LorenzoBalducci96/custom-cdj/README.md

# custom-cdj
A raspberry-pi Cdj project realized with the usage of mixxx for the audio software and Arduino Leonardo for input reading. The MIDI protocol is used for the communication between Arduino and the Raspberry.
