LorenzoBalducci96/custom-cdj/documentation.pdf

# Mixxx-based cdj

## A raspberry-pi Cdj project realized with the

## usage of mixxx for the audio software and

Arduino Leonardo for input reading.

## The MIDI protocol is used for the communication

between Arduino and the Raspberry.

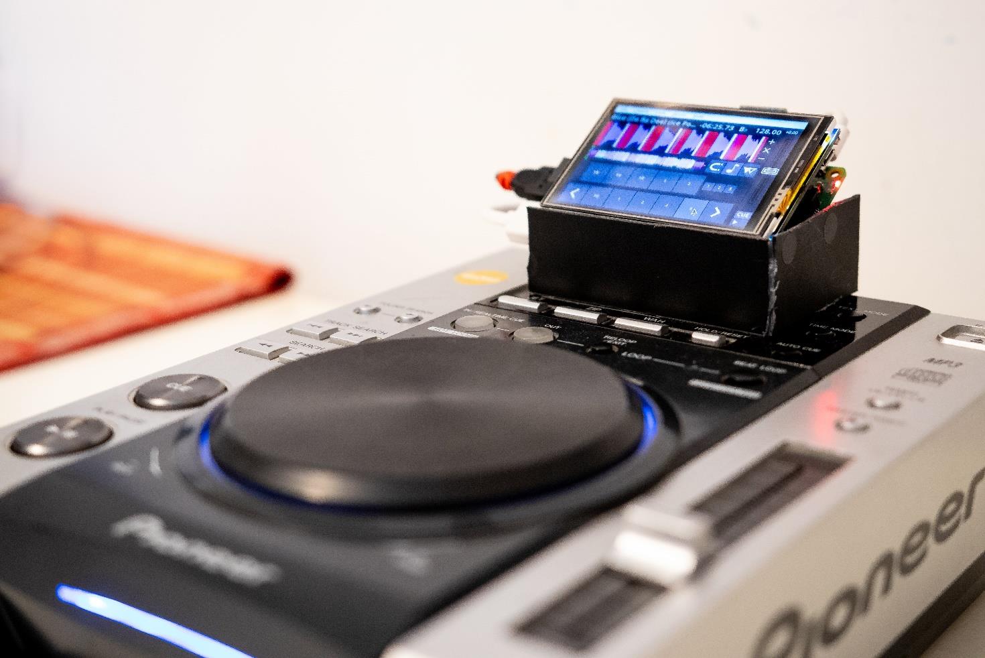
[picture p3: figure]

## Lorenzo Balducci

github: https://github.com/LorenzoBalducci96/

## Used material (for 1 cdj):

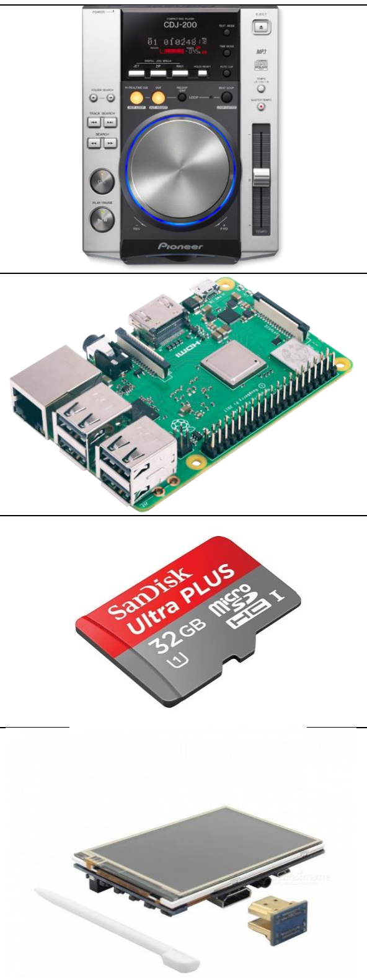
[picture p4: figure]

cdj | In this project we will refer to the pioneer cdj 200. You can use a broken one (all the buttons you want to use, the pitch and the jog must be in working conditions). You can even build your own using buttons, switch, rotary encoders…
raspberry pi 3 b+ | Not tested on other raspberry pi. We will use for running mixxx with our personalized skin.
Micro Sd card | You need a micro sd card because the raspberry pi doesn’t have an internal memory and uses an external sd card for the mass storage.
Raspberry pi screen | I used a 3.5” screen with a 480x320 resolution with touch screen support. You can use a different one but consider that the mixxx skin is all pixel-binded, so if you choose a screen with a different resolution, you will have to scale or adapt my skin. Moreover the waveform will be very fluid with a solid 60fps in a 320p resolution, but will be laggy on higher res.

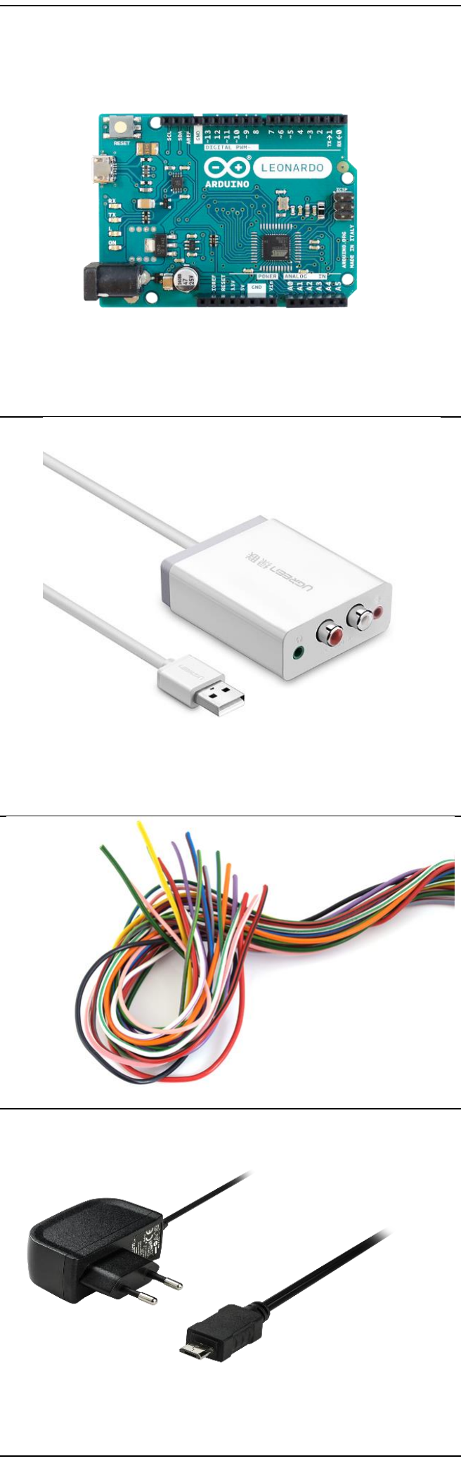
[picture p5: figure]

Arduino leonardo | You have to use the Leonardo version of Arduino because we will use the serial communication over usb. We will use Arduino for continuously reading input data from the cdj and sending over MIDI protocol to the raspberry pi.
Usb sound card | We will use an external sound card for a better sound quality and for reduce latency on mixxx. (You can find very good and cheap usb sound cards but also the 3.5mm jack audio on the raspberry isn’t all that shame).
Electric wires | Used for Making connections between cdj and Arduino.
Raspberry power supply | Classic 5v usb plug (Raccomanded minimum output of 2.5A).

Arduino power supply | You should provide an external power source for Arduino unless you will have a lot of noise on analog reading. Raccomended a 9v.
4.7K Resistors | Used for driving leds. If you don’t want a “bright” cdj you don’t need resistors.

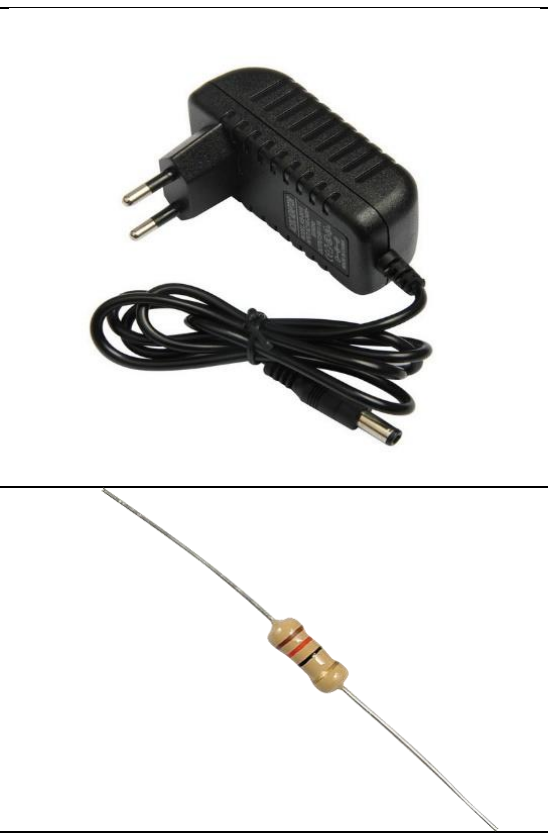
[picture p6: figure]

Of course screwdrivers, welder, and heat-resistant tape.

Fase 1: preparing the cdj

The first step is to prepare the cdj for the connection to the Arduino board.
If you decided to build your own cdj feel free to jump to the next step because here, we are going to analize the disassembly process of pioneer cdj 200.

As stated before, we want to throw away the cdj player and the logical unit from the cdj because we will use just the “buttons”, and we will inject another control unit.

A good video guide that you can follow is this https://www.youtube.com/watch?v=enjz8VNCzuE but please note that you don’t have to disassembly the boards on the upper side of the cdj (the silver one) but you just have to “clean” the bottom side (the black one).

In the end you should have this:

The silver upper part of the cdj:

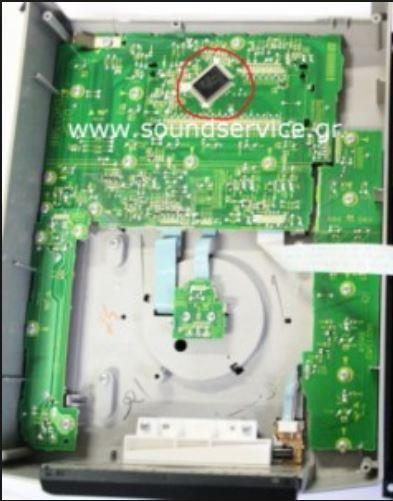
[picture p7: figure]

Disconnected from the bottom black part (leave alone the little flat on the upper part)

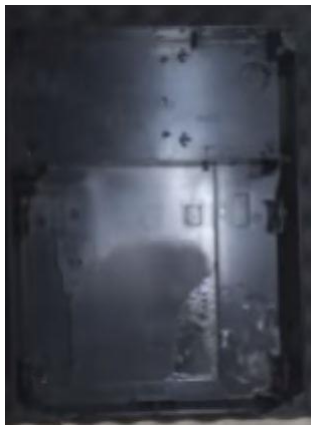
[picture p8: figure]

Fase 2: connecting all the buttons, the jog and the pitch to

Arduino.

Notice: all the buttons on the cdj board shares the same ground, so you have to connect to the Arduino gnp pin just one ground. You can check with a multimeter that all the ground are nearly short-circuited.

Notice2: each end of the wire that will go to the cdj board must be welded.
Each end of the cable going to Arduino can just be plugged in.

In the Arduino code we will read all the buttons with the pull_up method (there are some exception that will be explained).

The decided standard for connections is this:

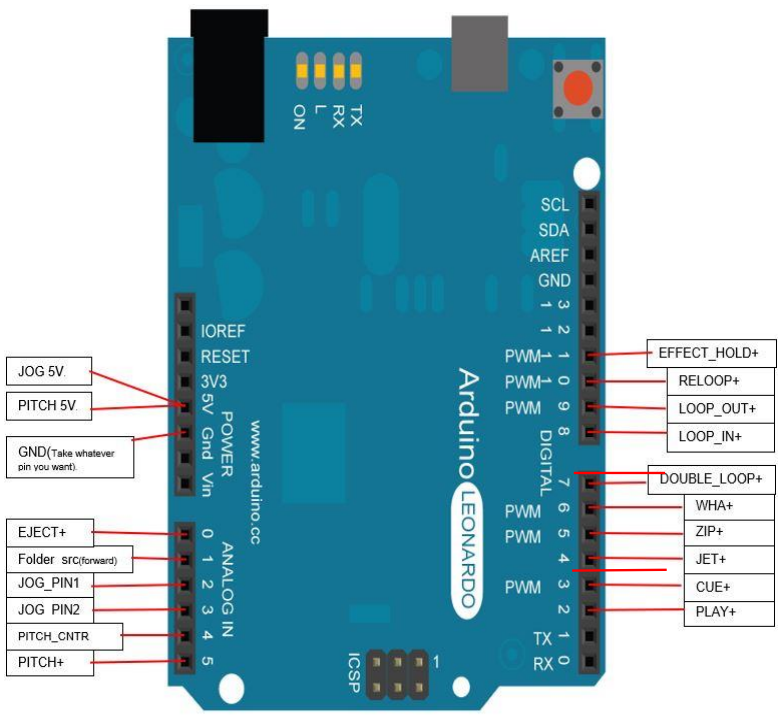
[picture p9: figure]

Some photos and explanations about the wiring on the cdj…

The CUE/PLAY BOARD.

The folder search (forward) button: note that there is a voltage divider between the navigations buttons.
So we connect just one button and in the Arduino code we will analize the voltage for guessing the button pressed.

The Button’s group interested:

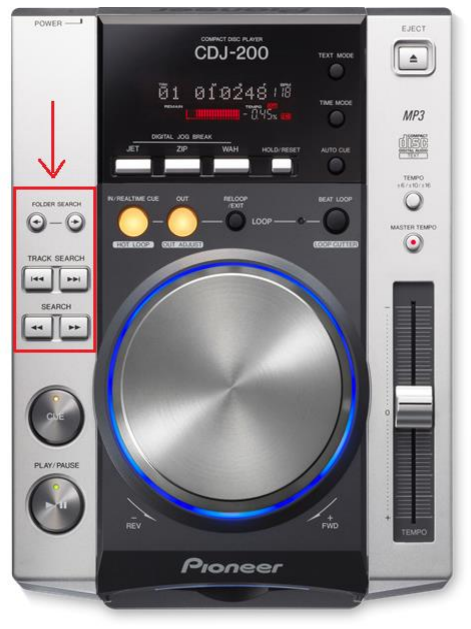
[picture p10: figure]

From now we will refer to this group of buttons as seek buttons.

The black wire is connected to the front led with a 4.7Kohm resistor (more detailed instructions at the end of the project).

The remaining 2 red wires are connected the the + pins of the cue and play buttons.

The gray wire is connected to GND of play button and

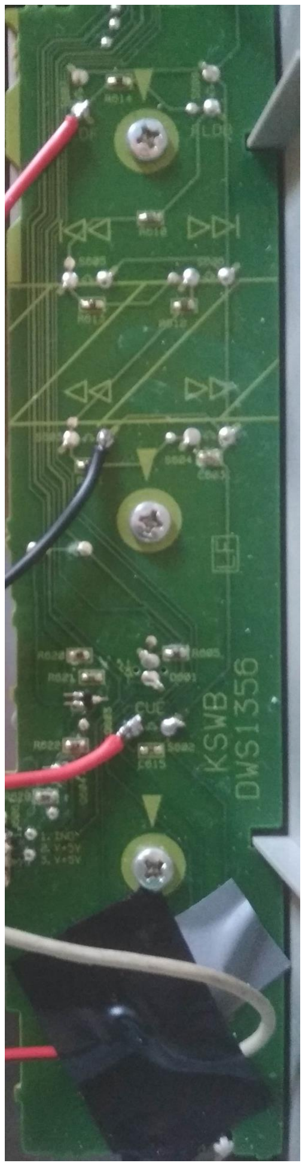
[picture p11: figure]

goes the the gnd pin of Arduino. (all the gnd pins are nearly short circuited so you can take another pin if you want).

The MAIN BOARD.

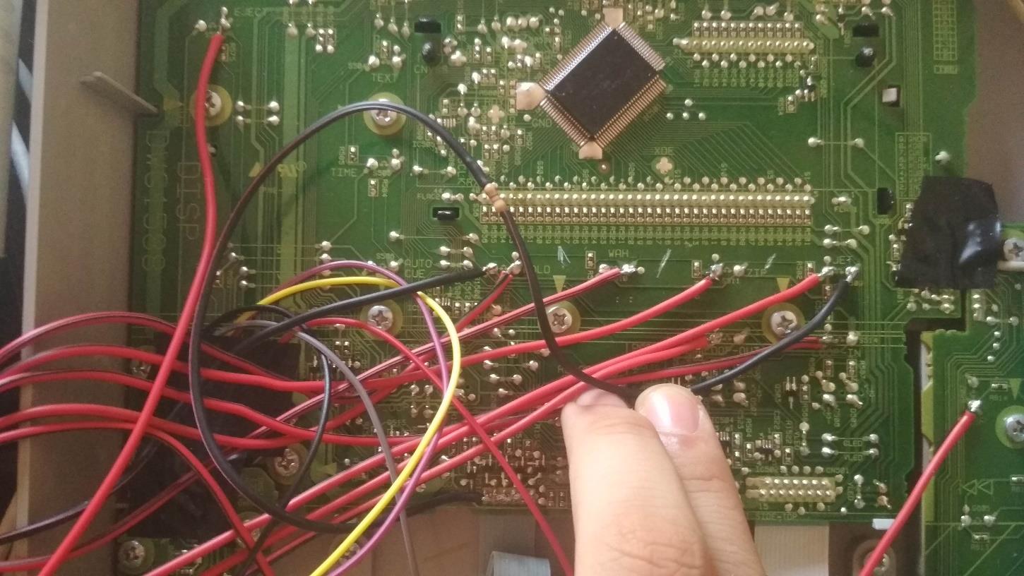
[picture p12: figure]

In the bottom line you have to connect the loop in, loop out, exit/reloop, and beat loop (double_loop) buttons (we will use the beat loop buttons to simulate the jog pressing from the moment that the cdj 200 hasn’t a touch sensitive jog).

There isn’t a clear view on the photo but consider that the loop in, loop out, and exit/reloop buttons have the positive pin on the left, the beat loop button has the positive pin on the right.

The black wire coming from the jet gnd pin (once again: is not important that I took the jet one for the gnd pins because are all short circuited) is connected with a 4.7Kohm resistor to the first five pins of the flat for powering leds.

Once again: if you are not interested to have led working in this cdj you can skip this step.

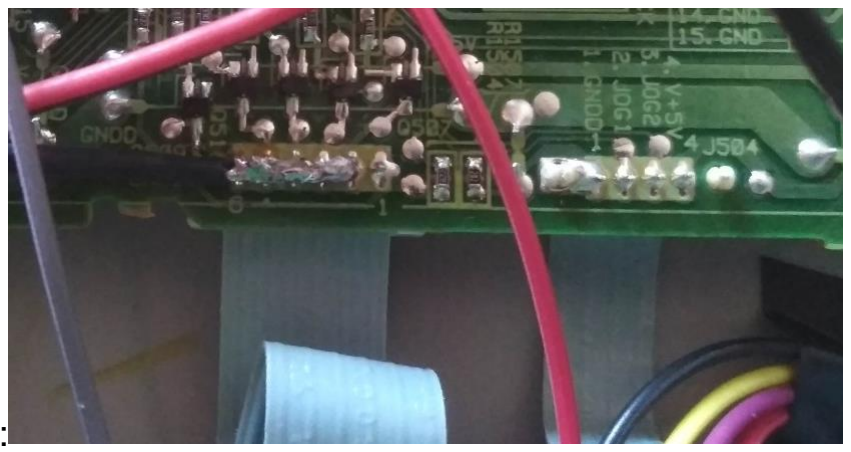
[picture p13: figure]

More detailed image:

Now let’s take a look in the effects section.
Here you have to connect the 3 effects button and the hold button (make shure to take all the + pins because as you can see in the picture, the jet and the zip buttons have the positive pin on the left, but the wah and the hold buttons have the positive pins on the right.
On the left pin of the hold button I took another gnd and I connected that too on the gnd Arduino pin.

As the search section, the effect section of the cdj 200 is realized with a tension divider, so we could have connected just one button and make in the Arduino code the same analog reading of the search section for guessing the pressed buttons.
Unfortunately the readings on a tension divider have some problems: the Arduino code and the analog readings takes precious time so we will have a less responsive cdj but the most important fact is that we can press just one button at the time.

From the moment that I decided to use the effects buttons for controlling hotcues on mixxx (the three effects are 3 hotcues and the hold button is the shift button for deleting them like a cdj 2000) we will usually press more than on button at the time.
So you have to break the connections between the buttons as shown in this photo:

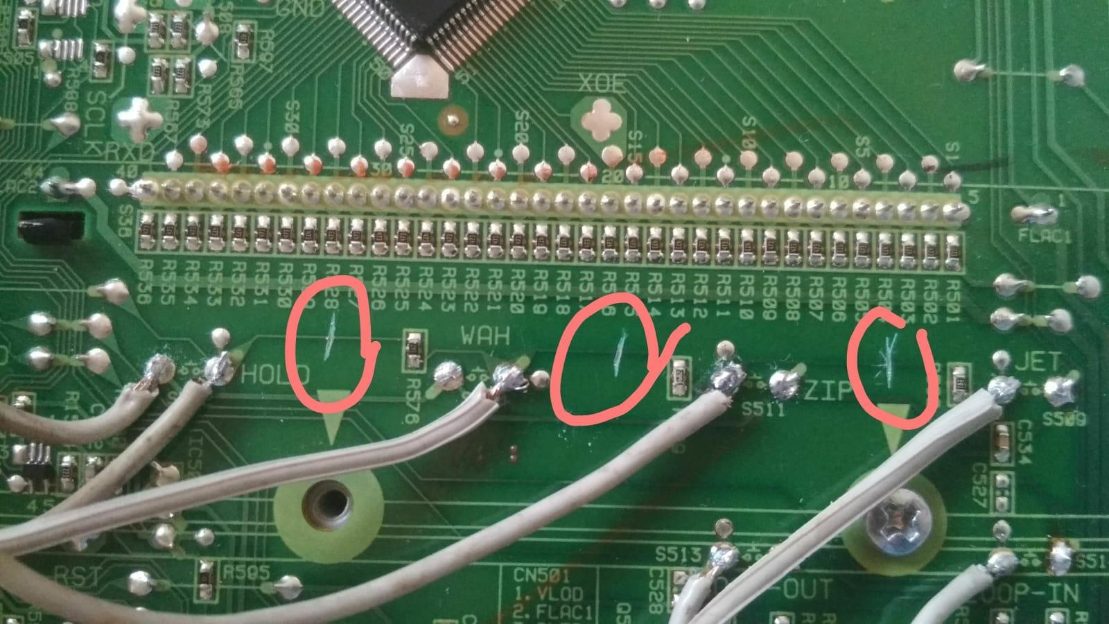
[picture p14: figure]

The last thing to connect on the main board is the eject button.
The eject button is inserted in a tension divider as for the search buttons and as for the effects buttons.
The buttons in questions are those in the picture.

From now we will refer to this group of buttons as function buttons.

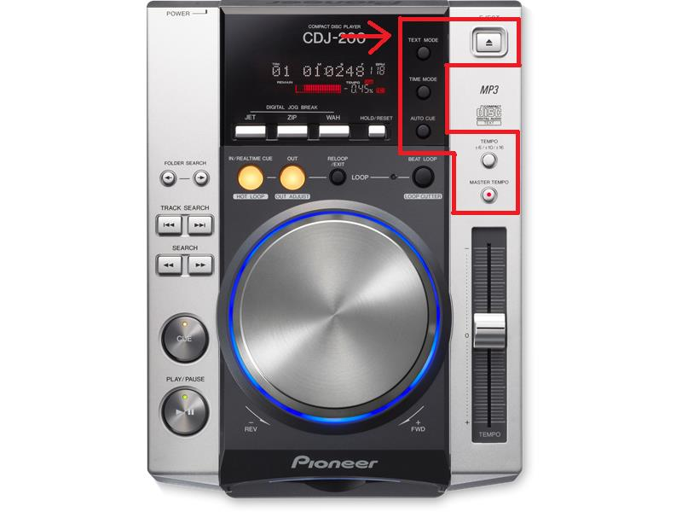
[picture p15: figure]

The PITCH BOARD.

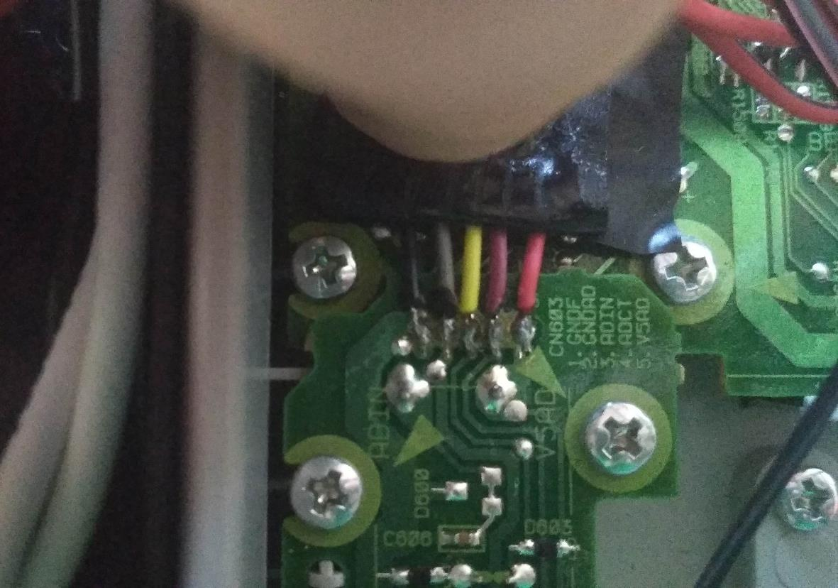
[picture p16: figure]

Here you have to connect these wires to the Arduino as shown in the initial schema:

From the moment that the logical names used in the initial schema are different from the ones used from pioneer in this board I’m going to make a table with the correspondence.

NOTE: THE GNDF AND GNDAD CONNECTIONS MAKE THE THINGS WORKING WELL BUT I DON’T KNOW WHY. I DON’T KNOW WHY THIS BOARD HAS 2 GND PINS.
IF YOU SHORT THEESE PINS NOTHING SEEMS TO HAPPEN AND THE THINGS WORK WELL.
IF YOU DON’T CONNECT THE SECOND GND PIN (GNDAD) YOU WILL HAVE MORE NOISE ON THE ANALOG READING) IF YOU DON’T CONNECT THE FIRST GND PIN (GNDF) NOTHING WILL WORK.

GNDF (black cable): is connected to all others gnd pins (you should have one more free gnd pin on Arduino).

GNDAD (gray cable): no I do not know exactly why you have to connect this pin but you have to.
For a good cable management I connected this pins to the gnd of the jogwheel.

ADIN (yellow cable): referred ad PITCH+ in the Arduino connection schema so connect it to the A5 pin.

ADCT (purple / red cable): referred ad PITCH_CNTR in the Arduino connection schema so connect it to the A4 pin.

V5AD: connect to 5v pin on Arduino Leonardo.

Quick explanation:

In the ADIN pin you will read a voltage between 0 and 5v (if connected to 5v power source) depending on the pitch position.
You could think that is very simple and if you read 5v the pitch is in the upper position(it’s right!), if you read 0v the pitch is in the bottom position (it’s right!) and if you read 2.5v this means that the pitch is exactly in the middle position (IT’S NOT RIGHT!).
When the pitch fader is exactly in the middle position in the ADIN pin you will read the same voltage shown in the ADCT.
In other words: in the ADCT pin you will read a static voltage indicating the voltage that you should read in the ADIN pin if the pitch is in the middle position.
So in the Arduino code we have to make shiftings of readed ADIN value in function of the ADCT value.

The JOG.

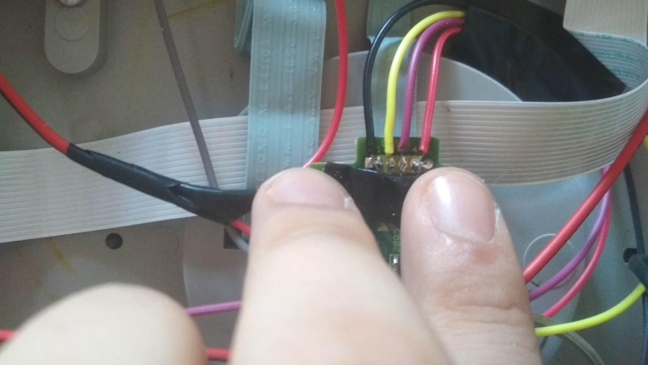
[picture p17: figure]

The jog drives a standard Rotary encoder: an encoder that use two digital square signal for coding left movement or right movement (in the Arduino code we will use a library for read those values easily).

Wires connections here are:
Black wire: connected the the GNDAD pin of the pitch as said before.

Yellow wire: connected to JOG_PIN1 so pin A2 (see Arduino connections schema).

Purple wire: connected to JOG_PIN2 so pin A3 (see Arduino connections schema).

Red wire: connected to 5v pin for power source.

Fase 3: preparing Arduino.

First of all you have to put Arduino in the black bottom shield of the cdj. For a well done jog you can use double sided adhesive tape.
I used black heat resistant tape.

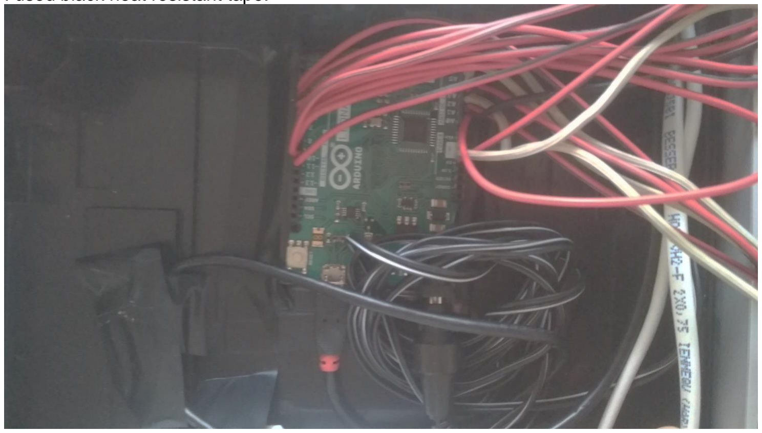
[picture p18: figure]

The twisted wire of the power plug goes the the 9v Arduino power supply.
The the other end of the usb cable seen in the picture is a normal usb plug that you will have to connect to the raspberry but for now just connect to the pc for loading the Arduino sketch.

In the pc, once you have installed Arduino ide (https://www.arduino.cc/en/Main/Software) and you downloaded the Arduino sketch from my repository (https://github.com/LorenzoBalducci96/custom-cdj/blob/master/midi-controlller-for-cdj.ino) you have to modify (if you want) the sketch and then load into your Arduino.
The used library are: “MIDIUSB” (easily findable on the official library repository) and “RotaryEncoder” (in particular I used the one in this repository: https://github.com/sivanandareddy/arduino-rotary-encoder-with-velocity.

Let’s make some consideration on the Arduino code:

After the warm up, in the loop It basically:
1. read all inputs (readButtons)
2. compare with the previous reading.
3. if there is a change there is a message sent and an update of the previous reading.
4. In the end there is 1 ms delay.(if you want a super responsive cdj you can decrease the delay using delayMicroseconds).

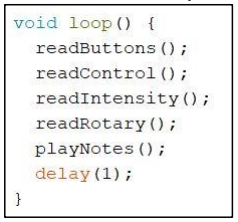
[picture p19: figure]

1) Read buttons: in this function we read all the normal buttons and save into a temporary array.

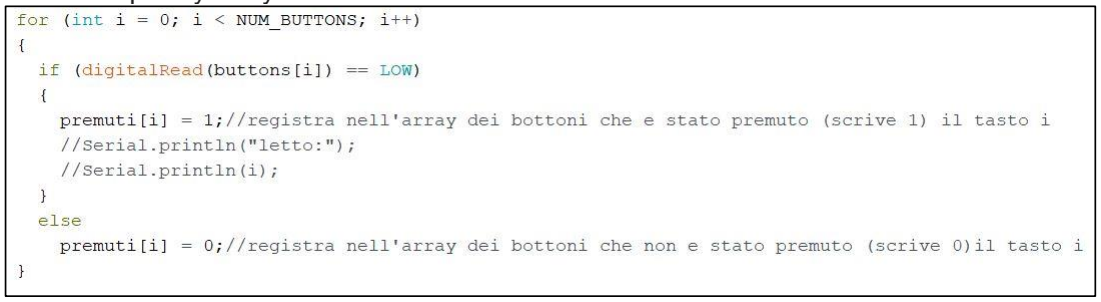
[picture p20: figure]

2) We also read all the tension divider wrapped buttons (seek buttons and functions buttons).

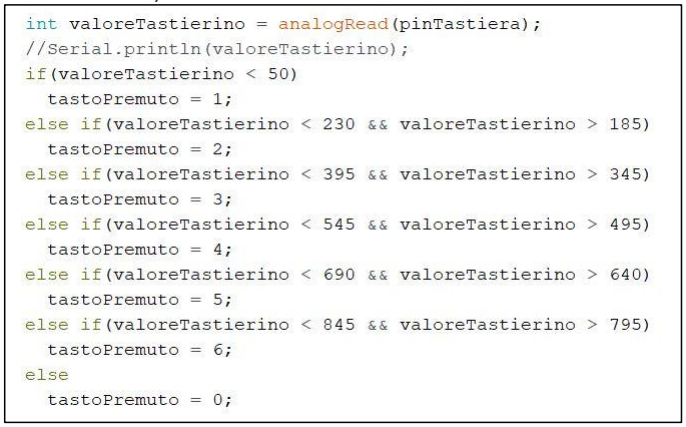
[picture p21: figure]

This is for the seek buttons, same for the functions buttons…

After the buttons reading we have the readControl function in which we read the control tension of the pitch (as said before there is a tension indicating the center position of the pitch).

In the readIntensity function we normally read the value of the pitch (we will have to map this readed value in function of the control value).

In the readRotary function we read the jog wheel rotation using the rotaryEncoder library mentioned before.

The encoder is defined in the warm up section. (refer to the library documentation for explanation).

In the playNotes function we will compare all the read values with the previousReadings, if there is a change we will sent a midi packed with the MIDIUSB library.

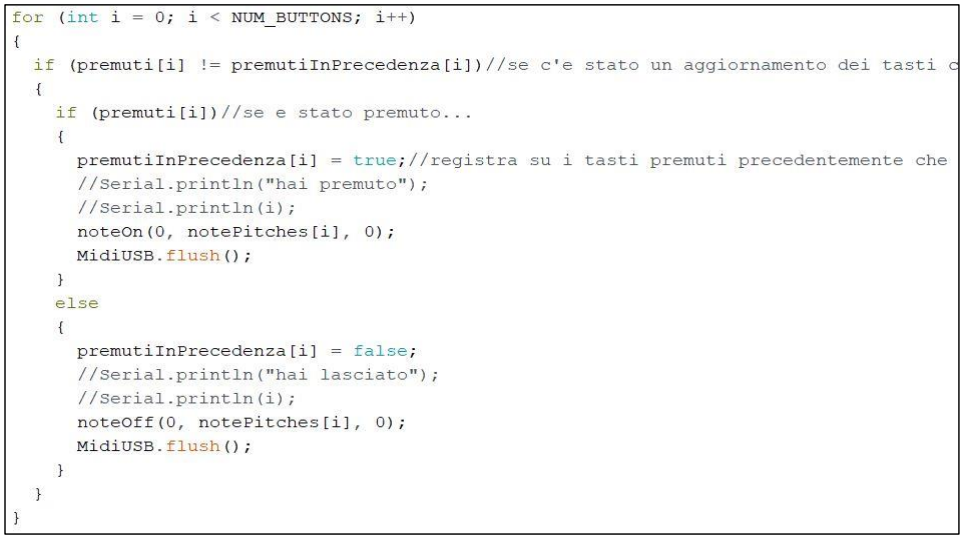
[picture p22: figure]

For the jogWheel we send the rotaryValue if there is a change (note that the library give us a value with 0 in the middle, using negative values fo anticlockwise turning and positive numbers for clockwise turning.
From the moment that the dj controlles midi standard expect a positive value centered in 64 we have to translate the value).

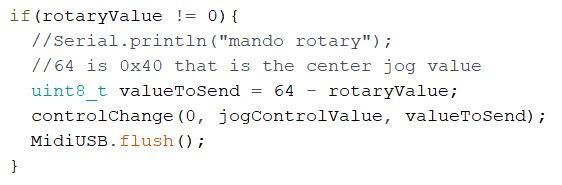
[picture p23: figure]

In the reading of the pitch I applied some filtering techniques because even if you use an external power supply you will still have some noise on analog reading.
Basically there is a window in witch if you readings changes a little, will not provoke new MIDI packets.
If the readings leave the window, you will have a MIDI packet sent and the sliding of the window. This is reached with the salendoScendendo var that indicate if we are sliding up the fader or sliding down. The rest of the code is auto-explained.
In this way you wil have very stable readings if you don’t touch the pitch, and you will have an impressive precision (much more than you had in the original cdj).
After these process the readed value is mapped using the controlValue because of the reason explained before.(the value is also mapped from 0-1023 to 0-16383 for respecting the midi standard).

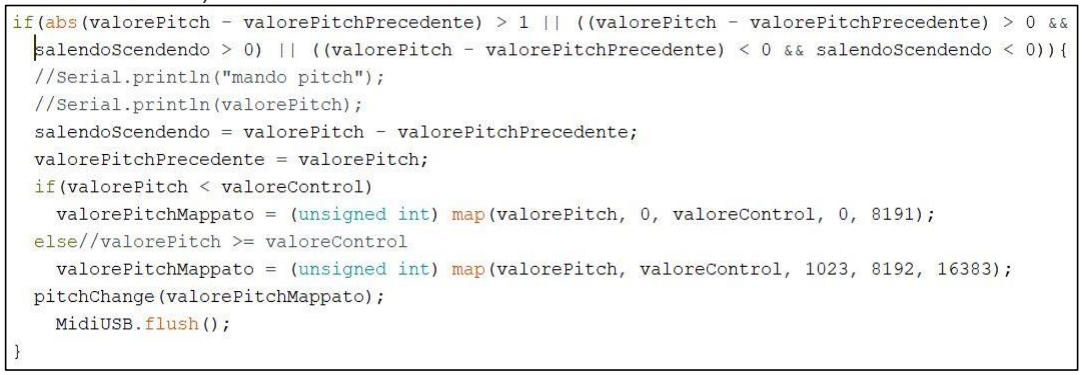
[picture p24: figure]

In the voltage divider sets of buttons the readings are filtered with the primaLetturaButtata for the seek sets of buttons and primaLetturaTempoButtata for the second voltage divider set of buttons.
These was made because when you press a button, the voltage doesn’t immediately goes down (due to the fisic of the voltage divider) and when you release the voltage doesn’t immediately goes up.
With these two vars we are going to check if in the last cycle we read the same value (in case this means that the voltage is stable and we can consider the button pressed).

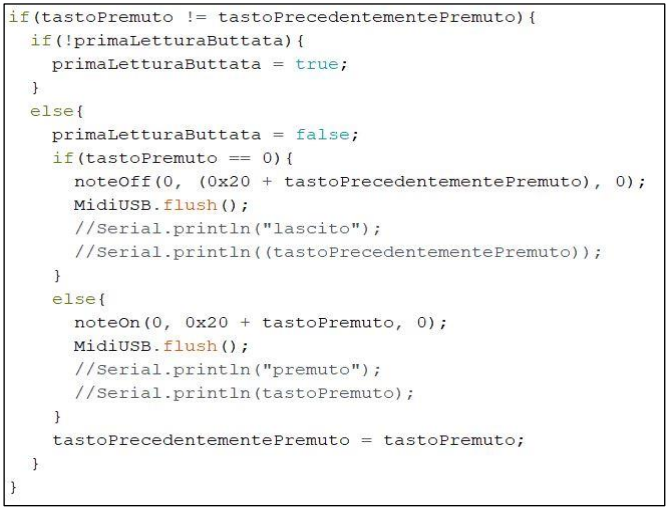
[picture p25: figure]

This is for the seek group buttons, same for the function buttons.

Fase 4.1: preparing the raspberry pi.

In this moment you basically have a “midi usb single deck cdj controller” that with the right mapping you can make it working with a plenty of dj mixing software.
We will provide a mapping for mixxx but first let’s prepare the raspberry.
You have to make your sd card suitable for the raspberry pi and you have to put there the operating system (Raspbian).
Please refer to the official site for download Noobs and for the installing procedure. https://www.raspberrypi.org/downloads/raspbian/

Fase 4.2: installing touch screen drivers and making the

screen work.

There isn’t a way for providing standard step for the touch screen drivers installing
because this depends on which touch screen you bought.
Normally raspberry touch screen takes power, video signal and touch screen data from the gpio.
The one used by me takes video signal from hdmi so it’s maybe a little different from the one that you probably have.
In any case you should have a cd inside the screen box with all the information for driver installing and swintching the output (if needed) from hdmi to gpio.
The touch basically provide a mouse data: when you press on a position of the screen you are moving the mouse in that position an pressing with the left mouse button.
This is perfect for making on skin mixxx buttons working.

Fase 4.3: installing mixxx.

You can install the mixxx version of the Raspbian repo by typing into the terminal:

sudo apt-get install mixxx

This will install mixxx 2.0.0 not the latest version 2.1 (today is 04/08/2018).
If you want the latest version you have to compile by yourself (not covered in this guide).

Fase 4.4: making the cdj working with the mapping file.

In this moment if you start mixxx (you can find into the graphical ui under audio → mixxx) and you go into preference menu, under the controller section if you see Arduino-Leonardo you are in the good way (of course arduino must be connected over usb cable to the raspberry before starting mixxx).
Now download from my repository the mapping file: https://github.com/LorenzoBalducci96/custom-cdj/blob/master/Arduino_Leonardo_MIDI_1.midi.xml (https://github.com/LorenzoBalducci96/custom-cdj/blob/master/Arduino_Leonardo_MIDI_1.midi.xml)
and the script file
https://github.com/LorenzoBalducci96/custom-cdj/blob/master/arduino-scripts.js

And put these files into your raspberry pi under:
/usr/share/mixxx/controllers/

For doing this you maybe need root permissions, so you can reach that folder in terminal and copy those files with
sudo cp “source_path” “destination_path”

in the other hand you can change the privilege to the mixxx/controllers folder with sudo chmod 0777 controllers

After this, restart mixxx and under preferences→controllers→Arduino Leonardo load the preset Arduino_Leonardo_MIDI_1.
Now you will have your controller working with mixxx.

Quick explanation about this mapping:
If you don’t understand the sense of some function read the user-guide manual for understanding what kind of mapping is decided and all will make sense.
In the xml file you have all the midi code mapped to a mixxx function.

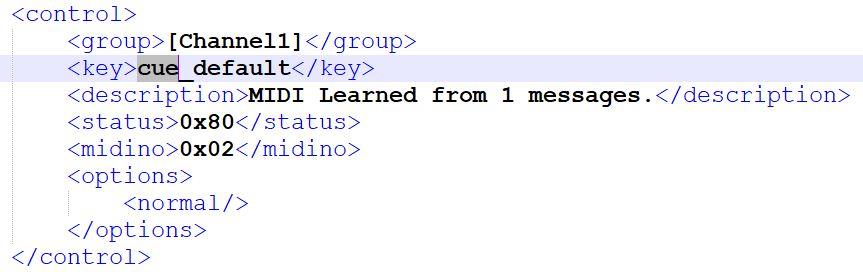
[picture p26: figure]

In this example we can see as the 02 midi code with the 80 status code (noteOn so buttonPressed) are mapped with the mixxx cue_default function.
We don’t need anything else for making the cue working.
All the simple buttons like this can be mapped with the learning wizard in mixxx.

More complex function like: shifting of the hotcues, jogwheel and pitch bend rate changing (between +- 10% and +-90%) are script binded.
These function are defined in the js file.

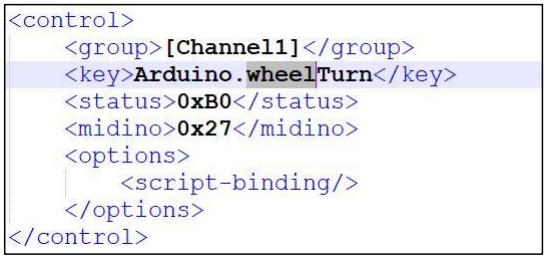
[picture p27: figure]

For example the turning of the jogwheel (midi control code 27) is mapped with the Arduino.wheelTurn function (described in the js file) infact in the options section there is the script-binding parameter.

In the js file infact we have the Arduino.wheelTurn function.

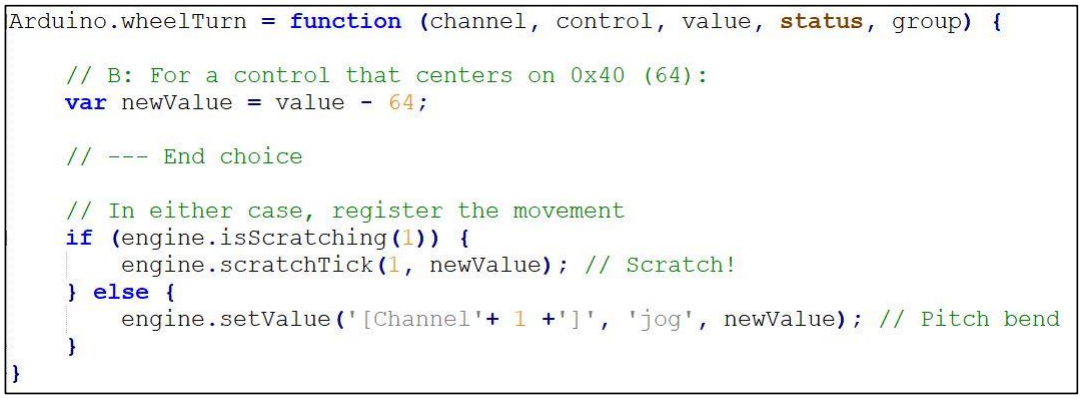
[picture p28: figure]

In which we will set the value of the jog rotation or of the scratch position in function of the isScratching value.
The isScatching value is true if the engine recognize that we are scratching (pressing the jogwheel but from the moment that the cdj 200 doesn’t have a touchable jogwheel we used the beal loop button for simulate the jog pressure as described before).

The touch of the jogwheel is also a script.
The midiControl message 0x27 with code NoteOn(0x90) or NoteOff(0x80)is mapped to whellTouch that enable/disable scratching on the engine.

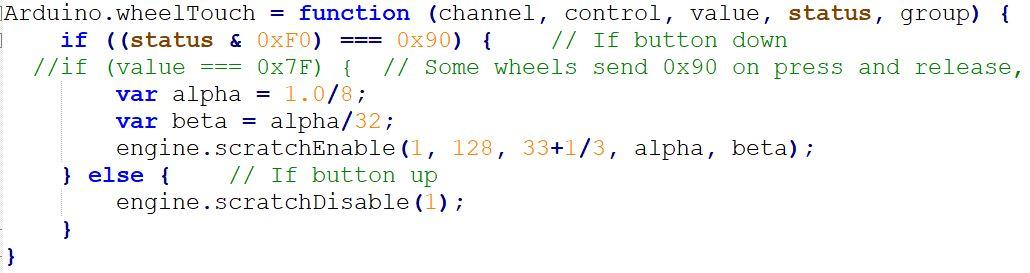
[picture p29: figure]
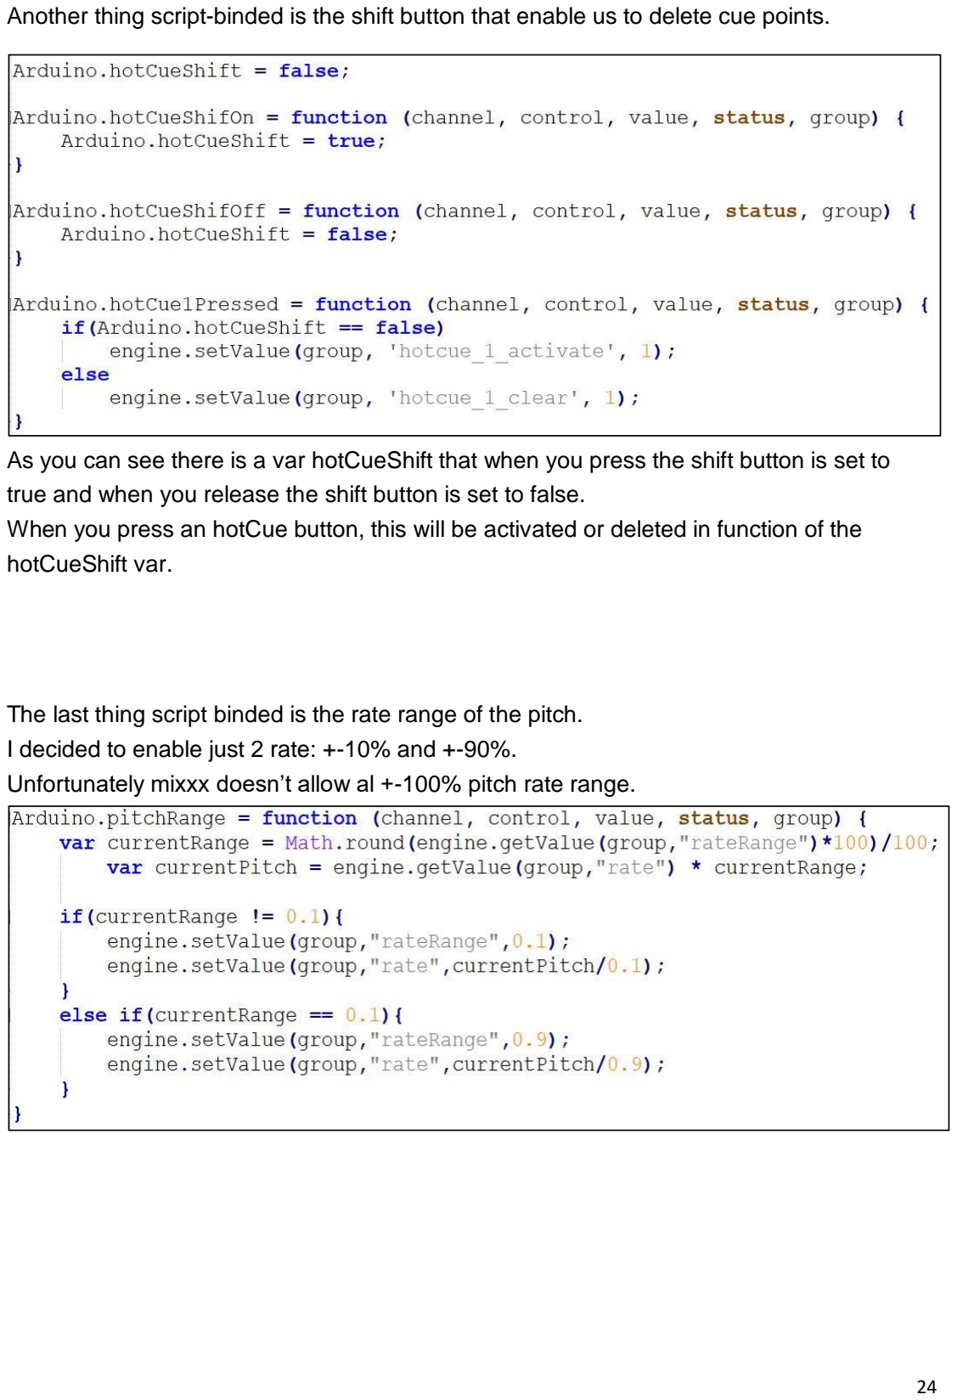
[picture p30: page 24]

Another thing script-binded is the shift button that enable us to delete cue points.

As you can see there is a var hotCueShift that when you press the shift button is set to true and when you release the shift button is set to false.
When you press an hotCue button, this will be activated or deleted in function of the hotCueShift var.

The last thing script binded is the rate range of the pitch.
I decided to enable just 2 rate: +-10% and +-90%. Unfortunately mixxx doesn’t allow al +-100% pitch rate range.

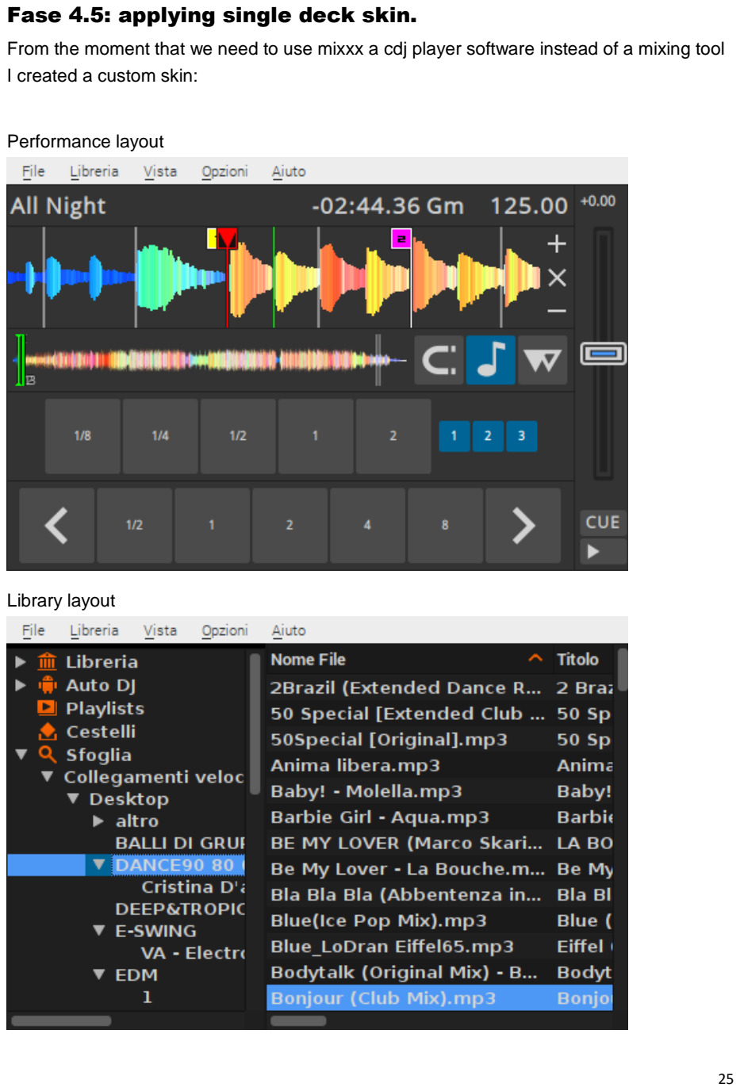
[picture p31: page 25]

Fase 4.5: applying single deck skin.

From the moment that we need to use mixxx a cdj player software instead of a mixing tool I created a custom skin:

Performance layout

Library layout

This skin is available inside a zip file on my GitHub https://github.com/LorenzoBalducci96/custom-cdj/blob/master/Skin.zip

It is based on the Deere default skin of mixxx.

Quick explanations of the files:

Skin.xml: most important layout definition (resolution, size of the buttons and piece of skins to display).
In the rest of the xml files describing the interface you will see reference for example to SquareButtonMinimumSize SmallSquareButtonMinimumSize…
All this size are described in this main file.
Note that the horizontal resolution isn’t exactly 480 but 484 because the touch part of my touch screen is a little bigger on the right that the screen.
With this trick I have something like a scroll bar on the right of the display because the scroll bar on the screen is across the edge of the screen, so touching outside of the screen will cause a touch exactly in the scroll bar.

MainDecks: this file describe the main layout of the decks (in our project is just one: deckLeft.xml) section. More detailed description is in others file:

deck_text_row.xml: describe this part of the layout

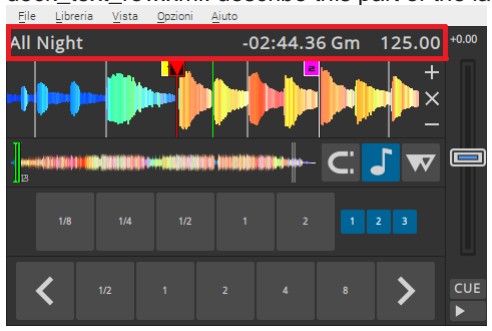
[picture p32: figure]

deck_visual_row.xml

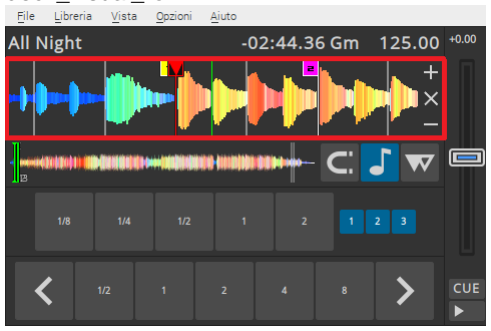
[picture p33: figure]

Deck_control_row.xml

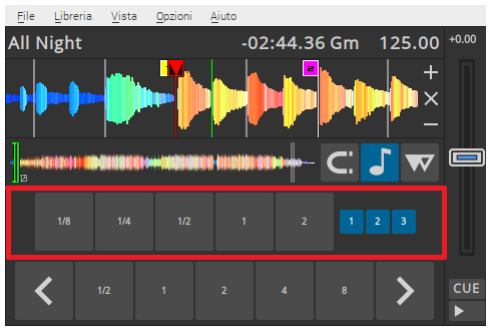
[picture p34: figure]

Inside deck_control_row.xml are called beatloop.xml

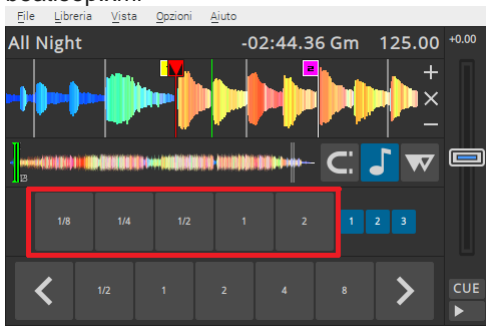
[picture p35: figure]

This beatloop.xml is different from the original because make the beatloop with the leftKey instead of the right.
In this way when you will touch this loops in the touchscreen you will make a left mouse click wich will (translate “scaturisce”) a loop roll.

hotcue.xml

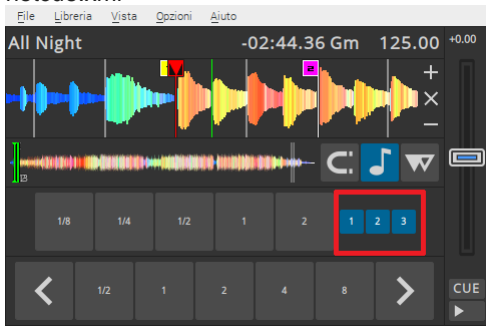
[picture p36: figure]

Is different from the original one because also here left and right function of the mouse are swapped.
In this way clicking on the touch screen on a hot cue will delete it instead of activating.
These are very little buttons because are just an indication if there is hotcues in memory (blue) or not (gray). You can call them or delete them with physical buttons and you don’t have to use the touchscreen.

deck_control_row2.xml

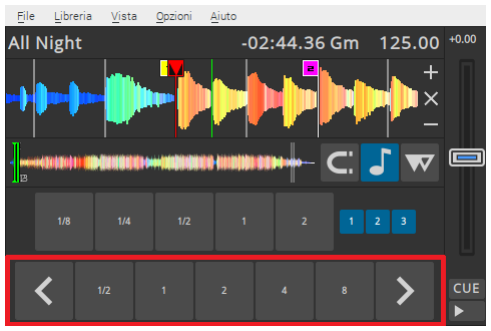
[picture p37: figure]

Inside deck_control_row2.xml is called beatloop2.xml that is the default beatloop.xml of the deere skin.
By left click you will activate a loop and adjusting length with left and right buttons.

deck_inner_column.xml

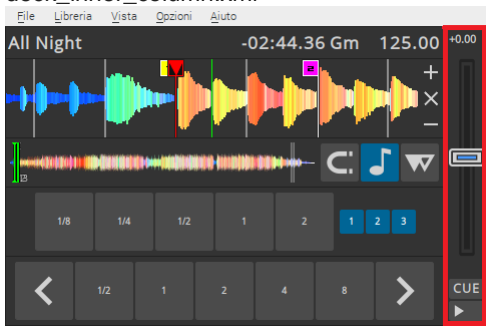
[picture p38: figure]

About the library layout there is not to much to say but how the switching between the performance layouot and the library one is handled?
The switching between the performance layout and library layout is reached by putting the library down the 320 pixels of the skin and when you press the button mapped for the full screen library you will have an overlapped library on the performance layout.
