LorenzoBalducci96/custom-cdj/skins/more_hotcues_480x320/more_hotcues.PNG

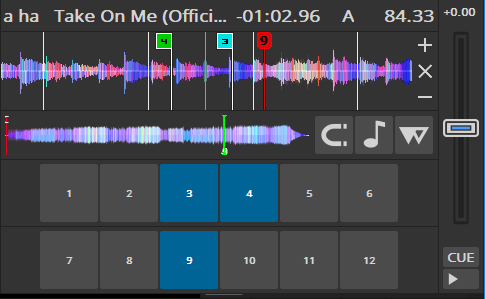
skins/more_hotcues_480x320/more_hotcues.PNG
