LorenzoBalducci96/custom-cdj/(threads)

Thread 3 (2019-11-30):

are you still working on this

midicdj1000, 2019-11-30:
HI, I have created my own PCB to go into cdj 1000 mk1,2 and 3. It's using a teensy 3.6 and I was using it with Traktor scratch. I just updated to fix a few issues with the addressable led I chose and issues with jog wheel movements and was looking at other options for using these and found your single deck MIXXX setup. Are you still working on this in any way ? I am quote interested and currently setting up to test my controller on it.

LorenzoBalducci96, 2019-11-30:
Hi, i'm still using these cdj's everyday, although i have no more updated the project because i have no necessity of other functions.
Really proud to help you in anyway.
If you have a mapping on the cdj 1000 that "emulate" another device (for example the cdj 2000), all you have to do is apply the custom skin to your mixxx release.
In the other hand you have to make the mapping for mixxx.

midicdj1000, 2019-11-30:
HI, I wrote the software myself so it does not emulate anything and I have to make the mixxx mapping. I actually did this before on my desktop pc, but I lost it so have to start again.

https://www.youtube.com/watch?v=VZxglNNLu-8&list=PLm24lW1EHXRBq56NebYlt-0IqBr6Gwxkd&index=9

It's nothing new so just pitch bend for the pitch movement and then CC commands for the jog wheel and encoders for loops ect. I use 64 as the middle with 63 and 65 to move forwards and backwards.

LorenzoBalducci96, 2019-12-01:
ok as the one that i used.
if you look at https://github.com/LorenzoBalducci96/custom-cdj/blob/master/Arduino_Leonardo_MIDI_1.midi.xml#L110
you can see that the code i used for pitch range midino is 0x52 (and of course 0x90 for status (that means button pressed)

in the javascript code for mapping:
https://github.com/LorenzoBalducci96/custom-cdj/blob/master/Arduino_Leonardo_MIDI_1.midi.xml#L110

you find the function for the pitch that act on the engine.

SUGGESTION: for all the other buttons you can use the auto learn function of mixxx.

midicdj1000, 2019-12-02:
I am using the learn function for basic buttons. Will take at look at the other parts when I can, Work is going to to be busy for the next few weeks.

midicdj1000, 2019-12-11:
HI, after a lot of trial and error I have the jog wheel turning and the pitch working as well as any normal buttons ect. I have not tried rotary encoders for browsing or loop size yet. It also has some problem when I go to scratch mode and it will not come back out. I was wondering if you know why the zoomed waveform is not showing ? It has the whole track waveform. How can i make it load into a playlist automatically ? it is very hard to use with just a cdj at the moment.

LorenzoBalducci96, 2019-12-12:
if you don't see the zoomed waveform on mixxx try to change waveform type (options -> preferences -> waveforms -> waveform type and try RGB).
The "waveform overwiew type" drop down list that you have under "waveform type" is for the full track waveform that, as you said, is showing, so don't touch.
What do you mean with load into a playlist automatically? you want the file browser to default put into "playlist" section?

LorenzoBalducci96, 2019-12-12:
For what regard the not come back out of the scratch mode: make shure that you have mapped both wheelTouch pressed ( midi 0x90 ) and wheelTouch release (midi 0x80).
If you are using the auto learn function, for auto learn the release button i suggest you to keep the jog pressed, start the auto learn and release; it will listen the 0x80 midi command.

4dvn, 2020-02-05:
> For what regard the not come back out of the scratch mode: make shure that you have mapped both wheelTouch pressed ( midi 0x90 ) and wheelTouch release (midi 0x80).
> If you are using the auto learn function, for auto learn the release button i suggest you to keep the jog pressed, start the auto learn and release; it will listen the 0x80 midi command.

Can you update the 2 waveform decks screen on a raspberry pi ?

LorenzoBalducci96, 2020-02-05:
what do you mean?
Are you asking if i'm able to get the mixxx waveforms working on a raspberry pi?

4dvn, 2020-02-05:
> what do you mean?
> Are you asking if i'm able to get the mixxx waveforms working on a raspberry pi?

I mean how to change the mixxx waveforms from single waveform to both waveforms on a screen

LorenzoBalducci96, 2020-02-05:
the skinn of this project is just one waveform because is designed to fit in the custom cdj project.
Can't you use an original skin that has 2 waveforms?

4dvn, 2020-02-05:
> the skinn of this project is just one waveform because is designed to fit in the custom cdj project.
> Can't you use an original skin that has 2 waveforms?

I use the ddj-400 and have plan to make it look like and xdj-rx2 on raspberry pi 3

LorenzoBalducci96, 2020-02-05:
so basically something like this but with the overview of the 2 waveforms one next to the other at the bottom of the screen?
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

4dvn, 2020-02-05:
Yes that it, i use the 3.5 touchscreen

LorenzoBalducci96, 2020-02-05:
For example you can use a skins like these that i just created.
[two_decks_mixxx_skins.zip](https://github.com/LorenzoBalducci96/custom-cdj/files/4162053/two_decks_mixxx_skins.zip)

this is the preview
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

The toggling between performance windows and library window should be achieved toggling full-screen library on and off as in my project.

In the zip file there are 2 skins that fit the most common raspberry pi screen resolutions (800x480 and 480x320) if you have a 3.5" display for shure you must use the 480x320 resolution.
Please apologize me but i managed the default deere skin without rearranging the code so in the folder there are tons uf useless files, this is uncomfortable for future modding of the skin.

I don't know if is correct to push this file into my repository because it is related to a slightly different project.

4dvn, 2020-02-07:
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

Here is my first test but when i load the skin is error on raspberry pi 3b+, maybe i is fail when copy:
https://www.instagram.com/tv/B8Q3YrRn96L/?igshid=whchwfwkgkp8

LorenzoBalducci96, 2020-02-10:
what error?

4dvn, 2020-02-10:
> what error?

the skin is too big on 800x840

LorenzoBalducci96, 2020-02-10:
have you tried the 480x320 one?
which is the resolution you are now using in the display?

Thread 5 (2020-07-13):

Waveforms not working in your skin & small design change request

lxxrxtz, 2020-07-13:
Hey Lorenzo!

I recently saw your video regarding your custom cdj-Project and wanted to make a similar one myself.

First I used the [skin](https://github.com/LorenzoBalducci96/custom-cdj/blob/master/skins/default_480x320.zip) you showed in your [video](https://www.youtube.com/watch?v=iwT1U_JUzzs) until I later found the skin I was kinda originally looking for after watching your video, made by you [here](https://github.com/LorenzoBalducci96/custom-cdj/issues/3#issuecomment-582615108). [This skin](https://github.com/LorenzoBalducci96/custom-cdj/issues/3#issuecomment-582615108) is exactly what I've been looking for and fills all my needs.

However I have this issues where with [your skin](https://github.com/LorenzoBalducci96/custom-cdj/issues/3#issuecomment-582615108) applied the waveforms won't show/load on my two Raspberry Pi 3B+'ses running Mixxx 2.2.0.
Is there a way to get them working?
Because I tried other skins that don't fit my 3.5 inch screen, however the waveforms in these skins loaded fine, where in yours, its not the case.
Any idea why?

Also, I wanted to ask you if you could tell me how to or if you can make a design change to this skins, where you change it from [what it looks like atm](https://github.com/LorenzoBalducci96/custom-cdj/issues/3#issuecomment-582615108) to [this](https://github.com/LorenzoBalducci96/custom-cdj/issues/3#issuecomment-582543059) because I would get a better overview from it.

Hope you're reading this and can provide me with solutions to my "problems" soon.

Kind regards,
Lauritz ;)

LorenzoBalducci96, 2020-07-14:
I tryied just now both skins on my raspberry pi 3b+ with mixxx 2.1.8 and mixxx 2.3.0 and are working.
Can you verify on settings->preferences->waveforms that you are using "RGB" setting for both waveform type and overview waveform?

lxxrxtz, 2020-07-14:
I will check

lxxrxtz, 2020-07-14:
Give me 2 minutes

lxxrxtz, 2020-07-14:
Ok, I checked. I had them on RGB (GSLS) for some Reason, that's why it wasn't working.

So that's fixed.

Could you do something about the design change for me too?

LorenzoBalducci96, 2020-07-14:
if you open the two_decks_waveforms.xml there is the structure of the layout you want to change.
There are two widget groups one with vertical layout in which you can find the two templates for the performance waveforms and another widget with horizontal layout with the two templates for the overview waveform.
Simply get rid of the second widget group and put the templates in the first in the order that you want.
In any case i will upload the skin in minutes.

lxxrxtz, 2020-07-14:
THANK YOU!
I‘ll Test the Skin tomorrow, so leave this thread open until then please, because I can then contact you in the event of something not working. If everything works, I’ll close the tomorrow by myself.

Thanks for you work! :)

LorenzoBalducci96, 2020-07-14:
[two_decks_vertical_layout.zip](https://github.com/LorenzoBalducci96/custom-cdj/files/4921336/two_decks_vertical_layout.zip)

lxxrxtz, 2020-07-15:
After almost 3 hours of testing it I can say that everything works fine now.
Thanks again for your help ;)

Closed 2020-07-15.

Thread 9 (2023-08-20):

Compile Problem with RotaryEncoder Library v.1.5.3 on Arduino IDE

Hemerson-Dev, 2023-08-20:
First of all, Congratulations Lorenzo !!!
This project is AWESOME !!!

Almost functions of my CDJ is working.

i tried to compile the code using RotaryEncoder library v.1.5.3 on Arduino IDE. Unfortunally the number of parameters are incompatible with this 1.5.3 version.

Can you post your RotaryEncoder library on this repository ?

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

Thread 10 (2023-09-06):

PitchToNote.h no such file or directory

Zkar521, 2023-09-06:
Ciao Lorenzo, innanzitutto voglio ringraziarti moltissimo per questo progetto, perché ho due cdj200, e grazie a te posso dargli un ottimo aggiornamento. Sono totalmente nuovo in questo campo, ma ho giá comprato tutto e ho eseguito la saldatura, solo nella fase di test dello sketch nell´ide di Arduino, ricevo questo errore -"PitchToNote.h" no such file or directory-, quindi ho provato a individuare quel file, I´ho aggiunto a sketch, ma ora ho quest´altro errore - No matching function for call to "RotaryEncoder::RotaryEncoder(const int&, const int&, int, int, int)"-, potete aiutarmi? Come posso aiutarla? Posso pagare per i tuoi consigli... Saluti dal Messico!!!

Hi Lorenzo, first of all I want to thank you very much for this project, because I have two cdj200, and thanks to you I can give them an excellent update. I´m totally new to this, but I already bought everything, and I did the soldering, but in the stage of the sketch, I´m getting this error -"PitchToNote.h" no such file or directory-, so I tried to locate that file, I added it to the sketch, but now I have another error -No matching function for call to "RotaryEncoder::RotaryEncoder(const int&, const int&, int, int, int)"-. Please, could you help me?, How can I support you? I can pay for your advice... Greetings from Mexico!!!
